M-S83/The-Coach-Analyst/hardware/enclosure-binocular/renders/view_back.png

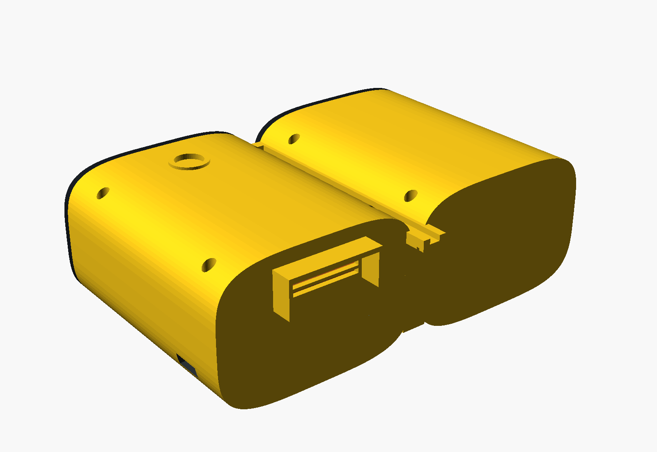
hardware/enclosure-binocular/renders/view_back.png
