M-S83/The-Coach-Analyst/hardware/enclosure-binocular/renders/view_exploded.png

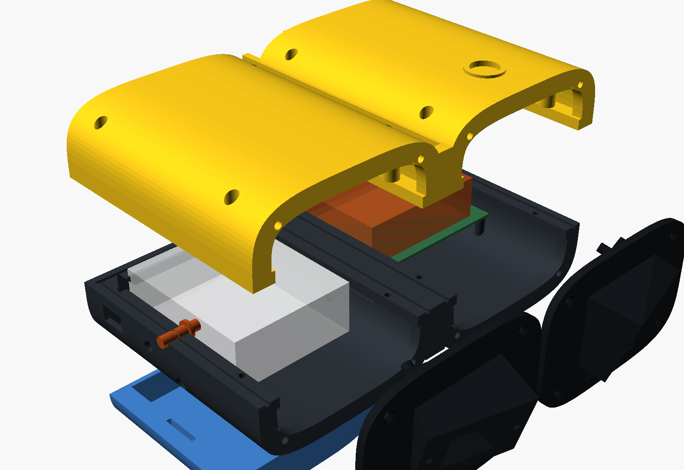
hardware/enclosure-binocular/renders/view_exploded.png
