M-S83/The-Coach-Analyst/hardware/enclosure-binocular/renders/view_front.png

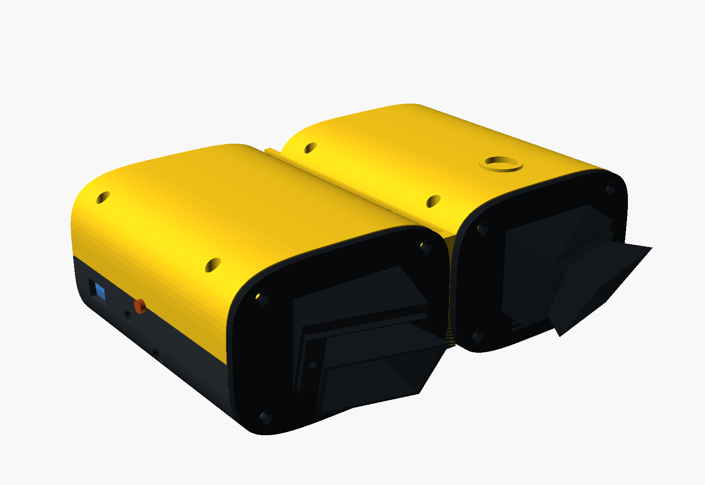
hardware/enclosure-binocular/renders/view_front.png
