M-S83/The-Coach-Analyst/hardware/enclosure-binocular/base.scad

// Base: lower half of both pods. Print in black ASA, flange face up, supports under the curved underside.
include <bino.scad>
translate([0, 0, pod_b]) base();
