M-S83/The-Coach-Analyst/hardware/enclosure-binocular/cradle.scad

// Battery cradle for the cool pod. Loose; lifts out with the bank.
include <bino.scad>
translate([0, -bank_yc, pod_b - wall]) cradle();
