M-S83/The-Coach-Analyst/(commit log)

2026-11-05 Add OpenSCAD model for the binocular camera enclosure
    Parametric parts for concept B: base, lid with rain channel, two nose
    plates with compound-angle camera pads, flared lens hoods sized to the
    6mm lens field of view, battery cradle, plunger and plugs, plus an
    assembly file and preview renders. Placeholder sizes are listed in the
    README until the parts are measured.
    Claude-Session: https://claude.ai/code/session_01FHYQy4hV3ZCwhzzwFnLpdn
    [assembly.scad, base.scad, bino.scad, cradle.scad, hood.scad, lid.scad, nose_cool.scad, nose_warm.scad]
2026-11-05 Add enclosure plans PDF
    Eight pages: the wedge concept, the binocular concept, and renders of
    the binocular OpenSCAD model.
    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
2026-11-05 Add transport case foam layout to the plans PDF
    Page 9 lays out pockets for the rig and match-day kit in the
    430 x 290 x 184 mm hard case.
    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
